ybabs/H745FCS/Hardware/CM4 Version/CM4.kicad_pcb

## KiCad design Hardware/CM4 Version/CM4.kicad_pcb (2022-01-23)

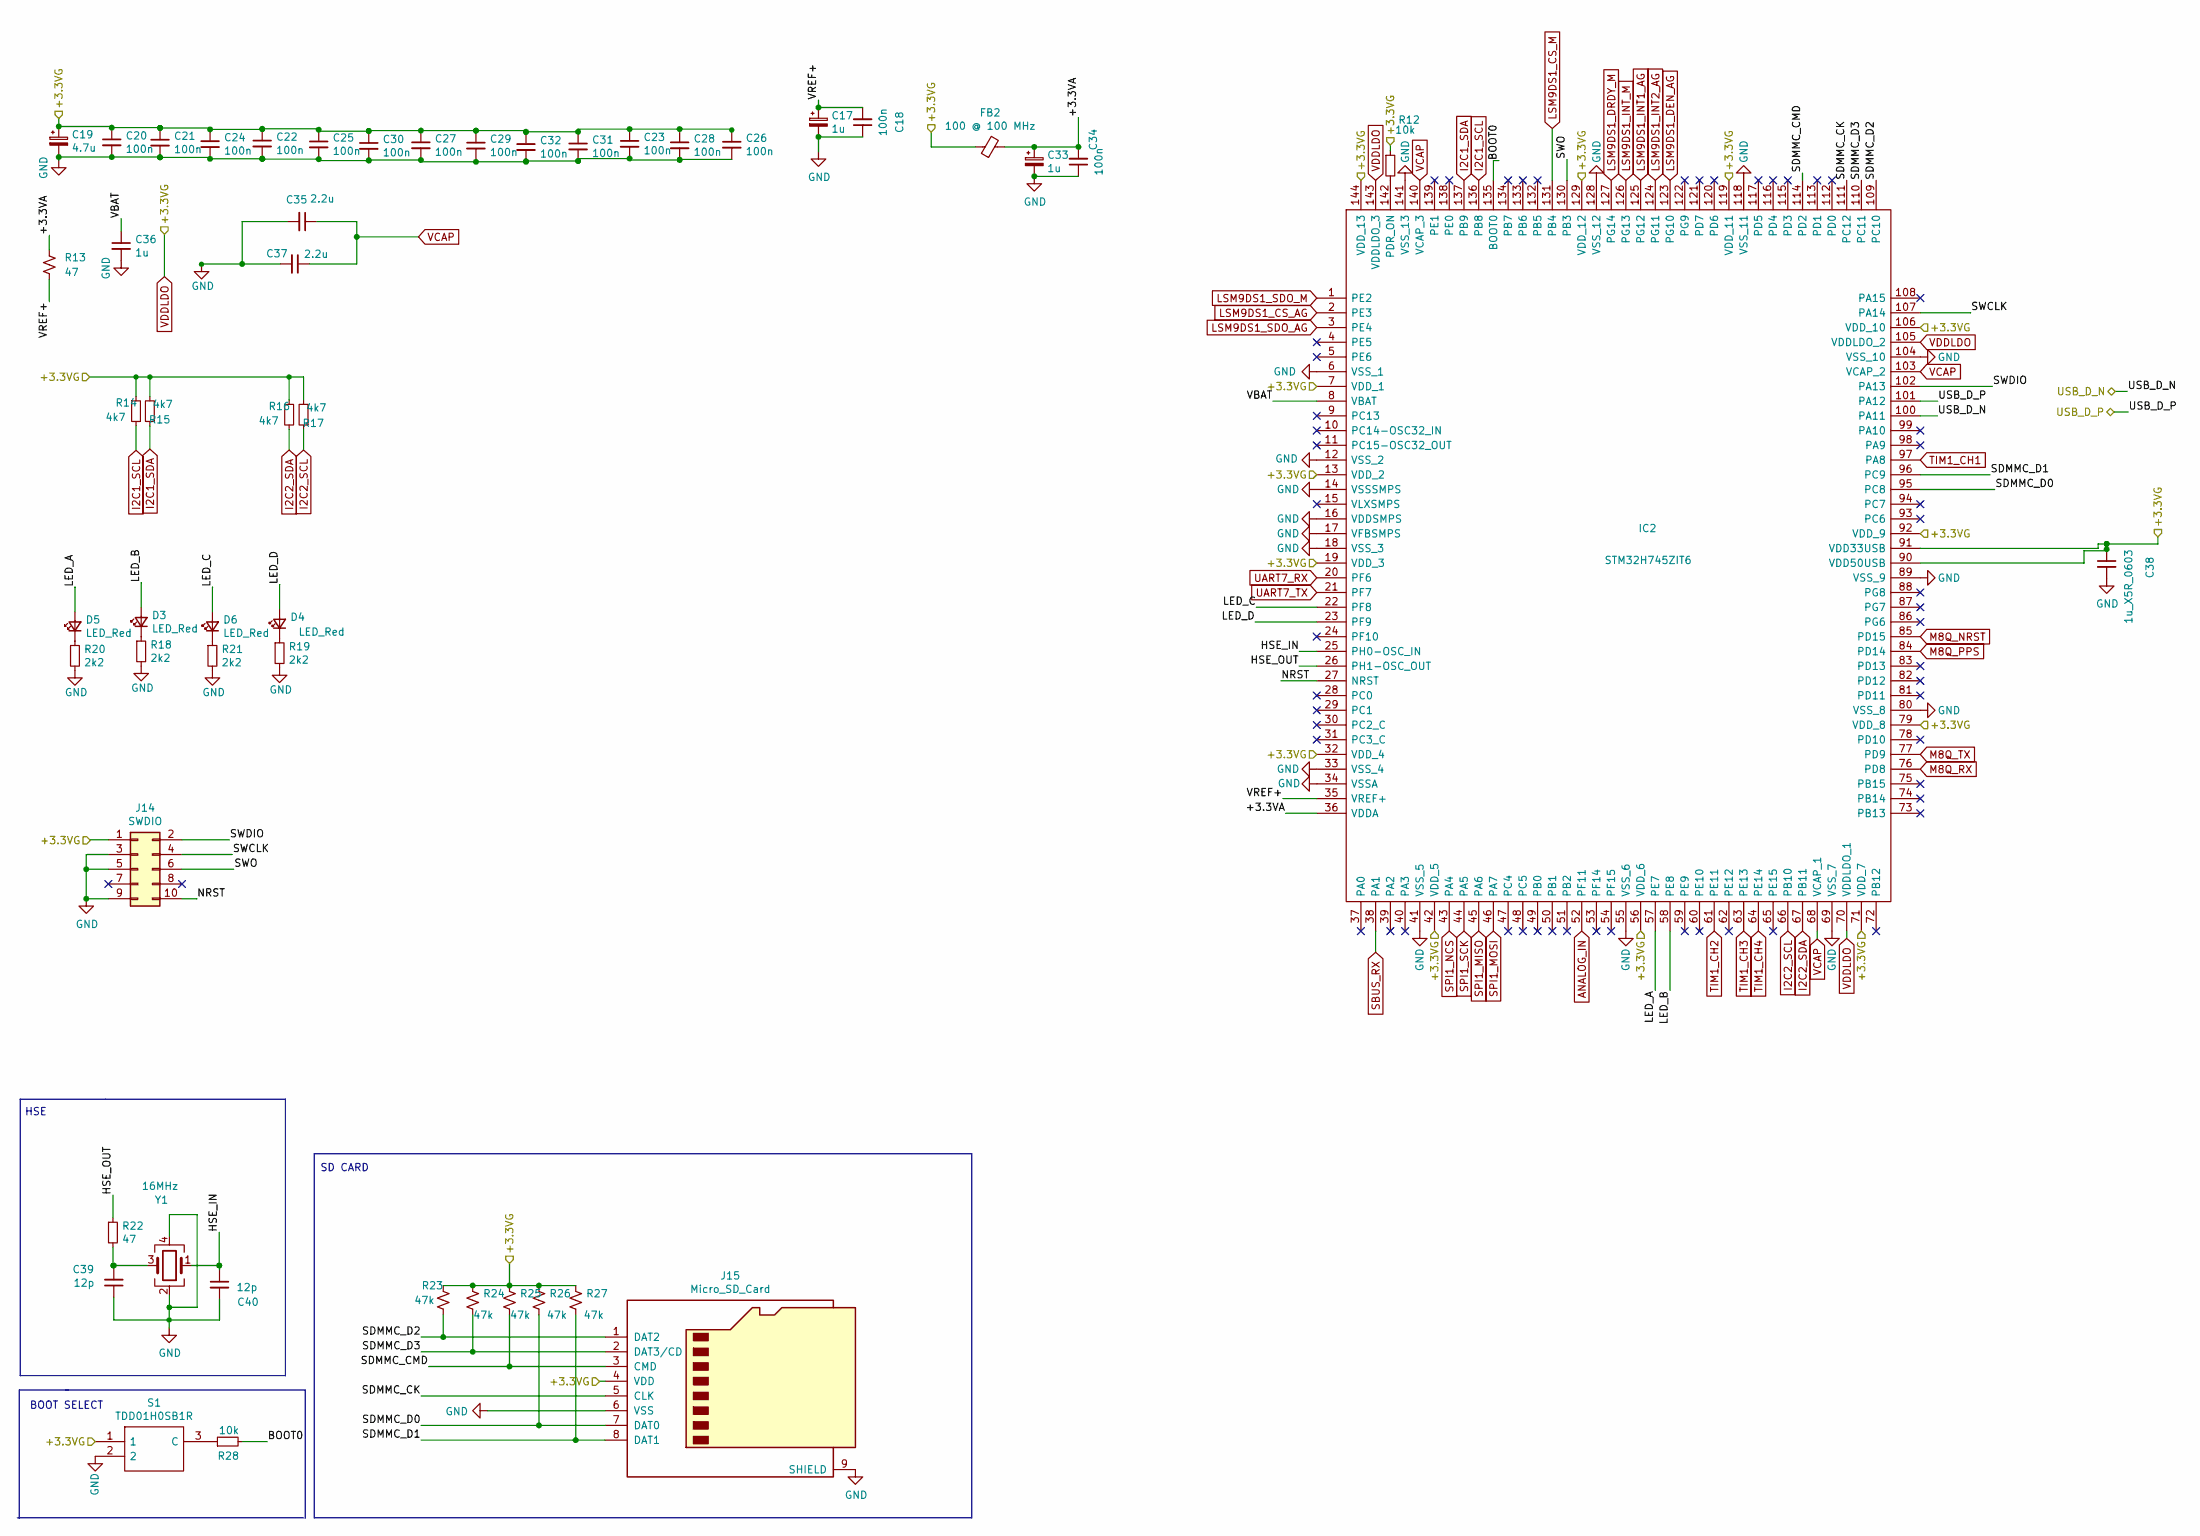
[picture p1: schematic H7MCU.kicad_sch]

Parts:
C17, C33: 1u; CP_EIA-3216-18_Kemet-A; Manufacturer_Part_Number TAJA105M016RNJ; LCSC Part # C7176
C18, C20, C21, C22, C23, C24, C25, C26, C27, C28, C29, C30, C31, C32, C34: 100n; C_0402_1005Metric; Digi-Key_PN 587-1226-2-ND
C19: 4.7u; CP_EIA-3216-18_Kemet-A; LCSC Part # C129235
C35, C37: 2.2u; C_0603_1608Metric; LCSC Part # C19666
C36: 1u; C_0402_1005Metric; Digi-Key_PN 587-1226-2-ND
C38: 1u_X5R_0603; C_0603_1608Metric; LCSC Part # C15849
C39, C40: 12p; C_0402_1005Metric; LCSC Part # C1547
D3, D4, D5, D6: LED_Red; LED_0603_1608Metric; LCSC Part # C72043
FB2: 100 @ 100 MHz; L_0603_1608Metric; Manufacturer_Part_Number MPZ1608S101ATAH0
IC2: STM32H745ZIT6; QFP50P2200X2200X160-144N; Manufacturer_Part_Number STM32H745ZIT6; Mouser Part Number 511-STM32H745ZIT6
J14: SWDIO; PinHeader_2x05_P1.27mm_Vertical
J15: Micro_SD_Card; microSD_HC_Hirose_DM3AT-SF-PEJM5; Manufacturer_Part_Number DM3AT-SF-PEJM5
R12, R28: 10k; R_0402_1005Metric; Digi-Key_PN RG10P10.0KDTR-ND
R13, R22: 47; R_0402_1005Metric; LCSC Part # C23182
R14, R15, R16, R17: 4k7; R_0402_1005Metric; LCSC Part # C23162
R18, R19, R20, R21: 2k2; R_0603_1608Metric; LCSC Part # C4190
R23, R24, R25, R26, R27: 47k; R_0402_1005Metric; Digi-Key_PN P47KDCTR-ND
S1: TDD01H0SB1R; SOT175P420X230-3N; Manufacturer_Part_Number TDD01H0SB1R; Mouser Part Number 611-TDD01H0SB1R
Y1: 16MHz; Crystal_SMD_3225-4Pin_3.2x2.5mm; Manufacturer_Part_Number X322516MLB4SI; LCSC Part # C13738

Connections:
/MCU/+3.3VA: C33.1, C34.2, FB2.2, IC2.36 (VDDA), R13.2
/MCU/BOOT0: IC2.135 (BOOT0), R28.2
/MCU/HSE_IN: C40.1, IC2.25 (PH0-OSC_IN), Y1.1
/MCU/HSE_OUT: IC2.26 (PH1-OSC_OUT), R22.1
/MCU/LED_A: D5.2 (A), IC2.57 (PE7)
/MCU/LED_B: D3.2 (A), IC2.58 (PE8)
/MCU/LED_C: D6.2 (A), IC2.22 (PF8)
/MCU/LED_D: D4.2 (A), IC2.23 (PF9)
/MCU/NRST: IC2.27 (NRST), J14.10
/MCU/SDMMC_CK: IC2.111 (PC12), J15.5 (CLK)
/MCU/SDMMC_CMD: IC2.114 (PD2), J15.3 (CMD), R25.1
/MCU/SDMMC_D0: IC2.95 (PC8), J15.7 (DAT0), R26.1
/MCU/SDMMC_D1: IC2.96 (PC9), J15.8 (DAT1), R27.1
/MCU/SDMMC_D2: IC2.109 (PC10), J15.1 (DAT2), R23.1
/MCU/SDMMC_D3: IC2.110 (PC11), J15.2 (DAT3/CD), R24.1
/MCU/SWCLK: IC2.107 (PA14), J14.4
/MCU/SWDIO: IC2.102 (PA13), J14.2
/MCU/SWO: IC2.130 (PB3), J14.6
/MCU/VBAT: C36.1, IC2.8 (VBAT)
/MCU/VREF+: C17.1, C18.2, IC2.35 (VREF+), R13.1
GND: C17.2, C18.1, C19.2, C20.2, C21.2, C22.2, C23.2, C24.2, C25.2, C26.2, C27.2, C28.2, C29.2, C30.2, C31.2, C32.2, C33.2, C34.1, C35.2, C36.2, C37.2, C38.2, C39.1, C40.2, IC2.6 (VSS_1), IC2.12 (VSS_2), IC2.14 (VSSSMPS), IC2.16 (VDDSMPS), IC2.17 (VFBSMPS), IC2.18 (VSS_3), IC2.33 (VSS_4), IC2.34 (VSSA), IC2.41 (VSS_5), IC2.55 (VSS_6), IC2.69 (VSS_7), IC2.80 (VSS_8), IC2.89 (VSS_9), IC2.104 (VSS_10), IC2.118 (VSS_11), IC2.128 (VSS_12), IC2.141 (VSS_13), J14.3, J14.5, J14.9, J15.6 (VSS), J15.9 (SHIELD), R18.2, R19.2, R20.2, R21.2, S1.2, Y1.2, Y1.4; also elsewhere on the board
I2C1_SCL: IC2.136 (PB8), R14.2; also elsewhere on the board
I2C1_SDA: IC2.137 (PB9), R15.1; also elsewhere on the board
I2C2_SCL: IC2.66 (PB10), R17.1; also elsewhere on the board
I2C2_SDA: IC2.67 (PB11), R16.2; also elsewhere on the board
unnamed: C39.2, R22.2, Y1.3
unnamed: D3.1 (K), R18.1
unnamed: D4.1 (K), R19.1
unnamed: D5.1 (K), R20.1
unnamed: D6.1 (K), R21.1
unnamed: IC2.142 (PDR_ON), R12.2
unnamed: R28.1, S1.3 (C)
VCAP: C35.1, C37.1, IC2.68 (VCAP_1), IC2.103 (VCAP_2), IC2.140 (VCAP_3)
VDDLDO: C19.1, C20.1, C21.1, C22.1, C23.1, C24.1, C25.1, C26.1, C27.1, C28.1, C29.1, C30.1, C31.1, C32.1, C38.1, FB2.1, IC2.7 (VDD_1), IC2.13 (VDD_2), IC2.19 (VDD_3), IC2.32 (VDD_4), IC2.42 (VDD_5), IC2.56 (VDD_6), IC2.70 (VDDLDO_1), IC2.71 (VDD_7), IC2.79 (VDD_8), IC2.90 (VDD50USB), IC2.91 (VDD33USB), IC2.92 (VDD_9), IC2.105 (VDDLDO_2), IC2.106 (VDD_10), IC2.119 (VDD_11), IC2.129 (VDD_12), IC2.143 (VDDLDO_3), IC2.144 (VDD_13), J14.1, J15.4 (VDD), R12.1, R14.1, R15.2, R16.1, R17.2, R23.2, R24.2, R25.2, R26.2, R27.2, S1.1; also elsewhere on the board

Notes on the sheet:
SD CARD
HSE
BOOT SELECT

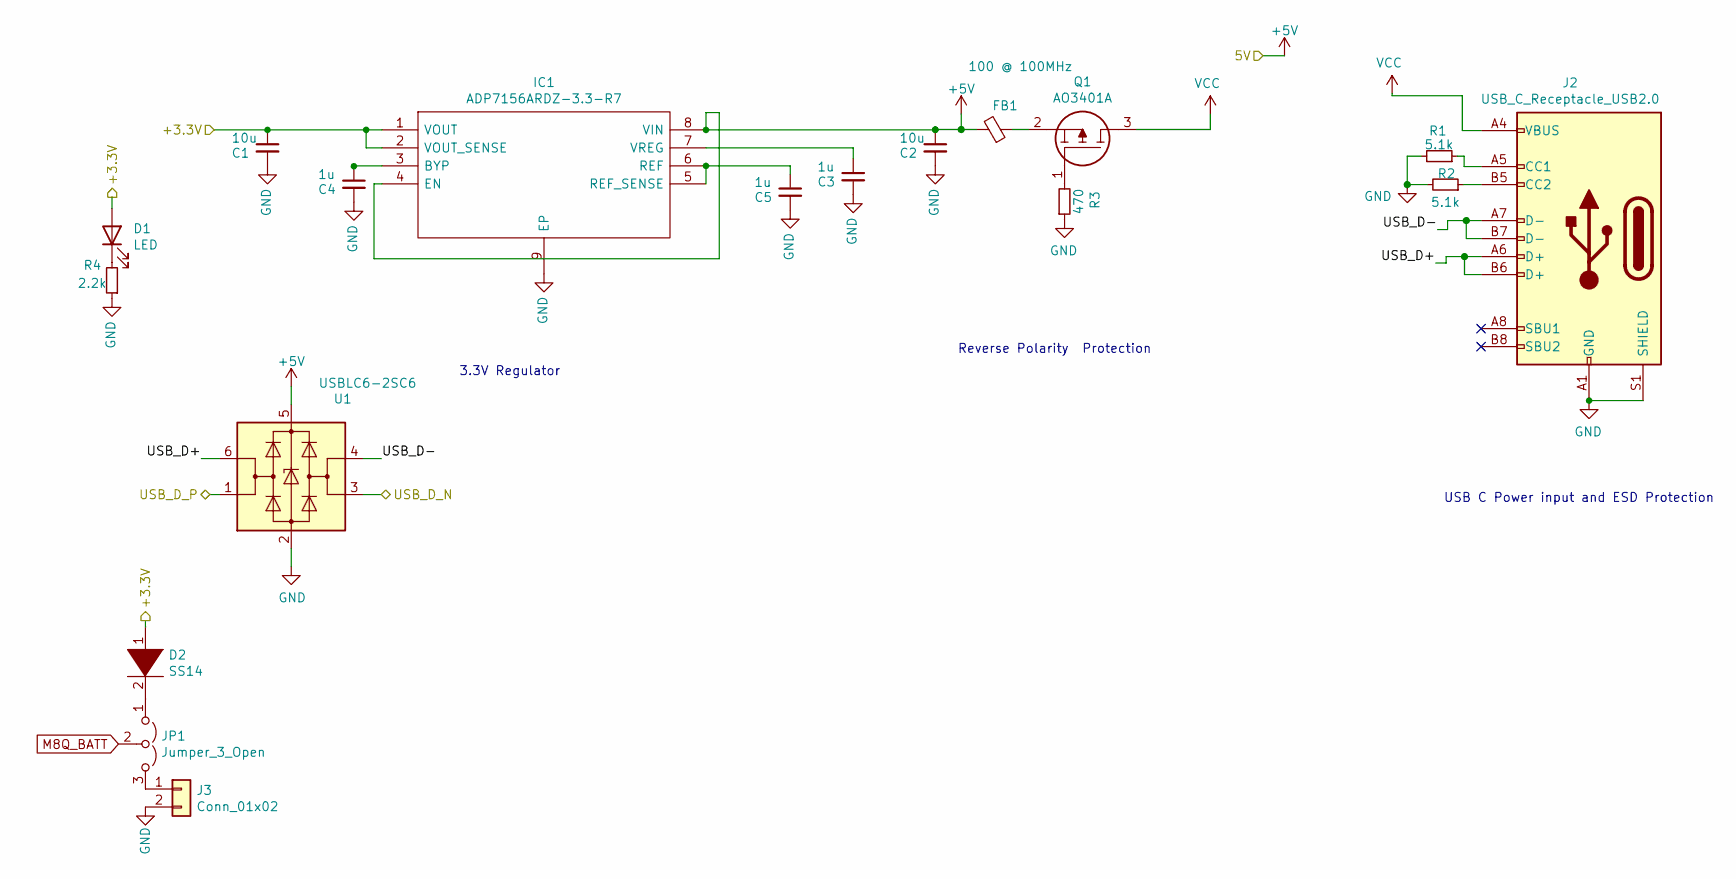
[picture p2: schematic power.kicad_sch]

Parts:
C1, C2: 10u; C_0603_1608Metric; LCSC Part # C19702
C3, C4, C5: 1u; C_0603_1608Metric; LCSC Part # C15849
D1: LED; LED_0603_1608Metric; LCSC Part # C72043
D2: SS14; D_SMA; LCSC Part # C111631
FB1: 100 @ 100MHz; L_0603_1608Metric; Manufacturer_Part_Number BLM21PG600SH1D
IC1: ADP7156ARDZ-3.3-R7; SOIC127P600X175-9N; Manufacturer_Part_Number ADP7156ARDZ-3.3-R7; Mouser Part Number 584-ADP7156ARDZ3.3R7
J2: USB_C_Receptacle_USB2.0; USB_C_Receptacle_HRO_TYPE-C-31-M-12; Manufacturer_Part_Number TYPE-C-31-M-12; LCSC Part # C165948
J3: Conn_01x02; Molex_PicoBlade_53261-0271_1x02-1MP_P1.25mm_Horizontal; Manufacturer_Part_Number 0532610271; Digi-Key_PN WM7620TR-ND
JP1: Jumper_3_Open; SolderJumper-3_P1.3mm_Open_RoundedPad1.0x1.5mm
Q1: AO3401A; SOT95P280X125-3N; Manufacturer_Part_Number AO3401A
R1, R2: 5.1k; R_1206_3216Metric; LCSC Part # C26033
R3: 470; R_1206_3216Metric; LCSC Part # C26033
R4: 2.2k; R_0603_1608Metric; LCSC Part # C4190
U1: USBLC6-2SC6; SOT-23-6; Manufacturer_Part_Number USBLC6-2SC6; LCSC Part # C7519

Connections:
+5V: C2.1, FB1.2, IC1.4 (EN), IC1.8 (VIN), U1.5 (VBUS); also elsewhere on the board
/Power/USB_D+: J2.A6 (D+), J2.B6 (D+), U1.6 (I/O1)
/Power/USB_D-: J2.A7 (D-), J2.B7 (D-), U1.4 (I/O2)
/Power/USB_D_N: U1.3 (I/O2)
/Power/USB_D_P: U1.1 (I/O1)
GND: C1.2, C2.2, C3.2, C4.2, C5.2, IC1.9 (EP), J2.A1 (GND), J2.A12 (GND), J2.B1 (GND), J2.B12 (GND), J2.S1 (SHIELD), J3.2, R1.2, R2.2, R3.1, R4.1, U1.2 (GND); also elsewhere on the board
M8Q_BATT: JP1.2 (C)
unnamed: C3.1, IC1.7 (VREG)
unnamed: C4.1, IC1.3 (BYP)
unnamed: C5.1, IC1.5 (REF_SENSE), IC1.6 (REF)
unnamed: D1.1 (K), R4.2
unnamed: D2.2 (A), JP1.1 (A)
unnamed: FB1.1, Q1.2
unnamed: J2.A5 (CC1), R1.1
unnamed: J2.B5 (CC2), R2.1
unnamed: J3.1, JP1.3 (B)
unnamed: Q1.1, R3.2
VCC: J2.A4 (VBUS), J2.A9 (VBUS), J2.B4 (VBUS), J2.B9 (VBUS), Q1.3
VDDLDO: C1.1, D1.2 (A), D2.1 (K), IC1.1 (VOUT), IC1.2 (VOUT_SENSE); also elsewhere on the board

Notes on the sheet:
3.3V Regulator
Reverse Polarity Protection
USB C Power input and ESD Protection

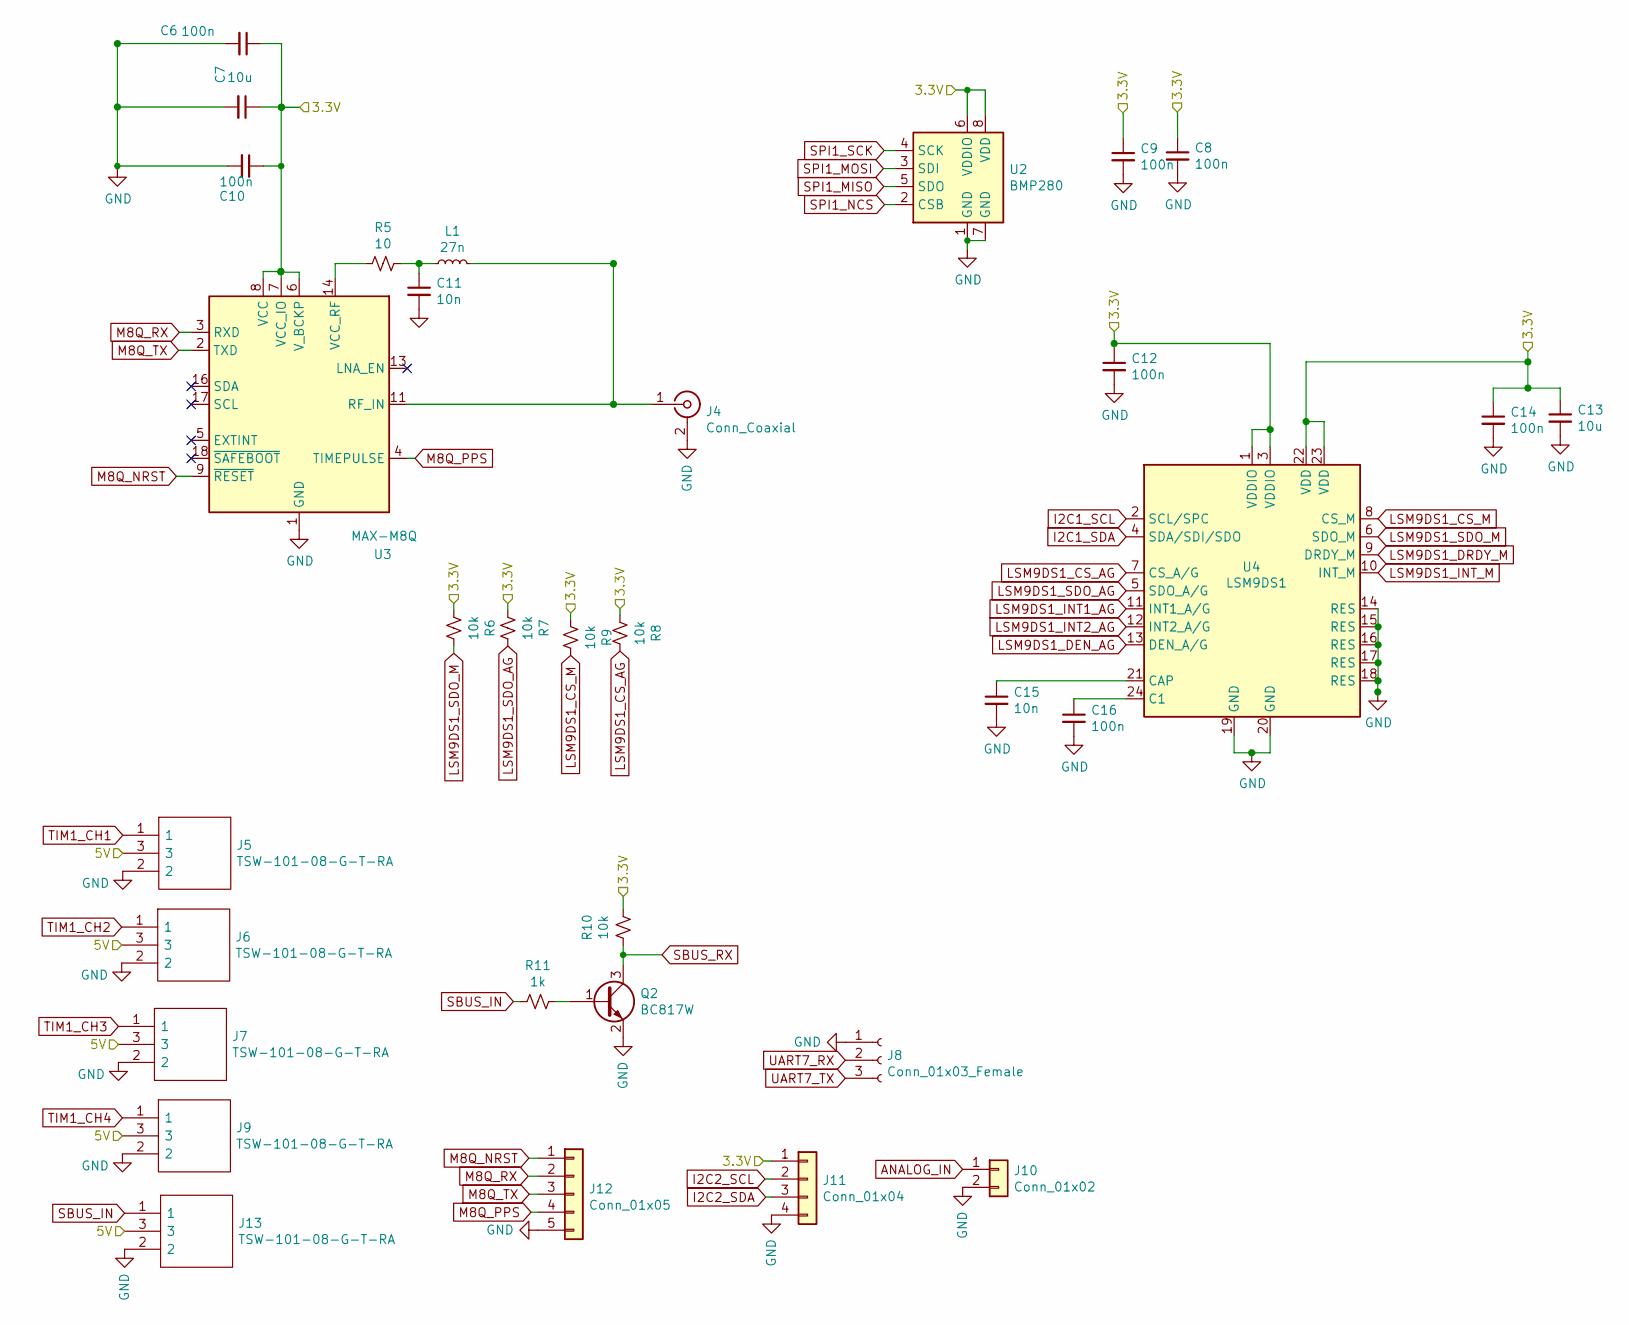
[picture p3: schematic Sensors.kicad_sch]

Parts:
C6, C8, C9, C10, C12, C14, C16: 100n; C_0402_1005Metric; Digi-Key_PN 587-1226-2-ND
C7: 10u; C_0603_1608Metric; LCSC Part # C15849
C11, C15: 10n; C_0402_1005Metric; LCSC Part # C15195
C13: 10u; C_0603_1608Metric; LCSC Part # C19702
J4: Conn_Coaxial; BWIPX-1-001E
J5, J6, J7, J9, J13: TSW-101-08-G-T-RA; HDRRA3W64P254_3X1_254X254X810P; Mouser Part Number 200-HTSW10108GTRA
J8: Conn_01x03_Female; PinHeader_1x03_P2.54mm_Vertical
J10: Conn_01x02; Molex_PicoBlade_53048-0210_1x02_P1.25mm_Horizontal; Manufacturer_Part_Number 0530480210; Digi-Key_PN WM1742-ND
J11: Conn_01x04; Molex_PicoBlade_53261-0471_1x04-1MP_P1.25mm_Horizontal; Manufacturer_Part_Number 0532610471; Digi-Key_PN WM7622TR-ND
J12: Conn_01x05; Molex_PicoBlade_53047-0510_1x05_P1.25mm_Vertical
L1: 27n; L_0402_1005Metric_Pad0.77x0.64mm_HandSolder; Manufacturer_Part_Number LQG15HS27NJ02D; LCSC Part # C18830
Q2: BC817W; SOT-323_SC-70; Digi-Key_PN 1727-4843-2-ND
R5: 10; R_0402_1005Metric; LCSC Part # C22859
R6, R7, R8, R9, R10: 10k; R_0402_1005Metric; Digi-Key_PN RG10P10.0KDTR-ND
R11: 1k; R_0402_1005Metric; LCSC Part # C21190
U2: BMP280; Bosch_LGA-8_2x2.5mm_P0.65mm_ClockwisePinNumbering; Manufacturer_Part_Number 314030010
U3: MAX-M8Q; ublox_MAX
U4: LSM9DS1; LGA-24L_3x3.5mm_P0.43mm; Digi-Key_PN 497-14946-2-ND

Connections:
ANALOG_IN: J10.1
GND: C6.2, C7.2, C8.2, C9.2, C10.2, C11.2, C12.2, C13.2, C14.2, C15.2, C16.2, J4.2 (Ext), J5.2, J6.2, J7.2, J8.1, J9.2, J10.2, J11.4, J12.5, J13.2, Q2.2 (E), U2.1 (GND), U2.7 (GND), U3.1 (GND), U3.10 (GND), U3.12 (GND), U4.14 (RES), U4.15 (RES), U4.16 (RES), U4.17 (RES), U4.18 (RES), U4.19 (GND), U4.20 (GND); also elsewhere on the board
I2C1_SCL: U4.2 (SCL/SPC); also elsewhere on the board
I2C1_SDA: U4.4 (SDA/SDI/SDO); also elsewhere on the board
I2C2_SCL: J11.2; also elsewhere on the board
I2C2_SDA: J11.3; also elsewhere on the board
LSM9DS1_CS_AG: R8.2, U4.7 (CS_A/G)
LSM9DS1_CS_M: R9.2, U4.8 (CS_M)
LSM9DS1_DEN_AG: U4.13 (DEN_A/G)
LSM9DS1_DRDY_M: U4.9 (DRDY_M)
LSM9DS1_INT1_AG: U4.11 (INT1_A/G)
LSM9DS1_INT2_AG: U4.12 (INT2_A/G)
LSM9DS1_INT_M: U4.10 (INT_M)
LSM9DS1_SDO_AG: R7.2, U4.5 (SDO_A/G)
LSM9DS1_SDO_M: R6.2, U4.6 (SDO_M)
M8Q_NRST: J12.1, U3.9 (~RESET)
M8Q_PPS: J12.4, U3.4 (TIMEPULSE)
M8Q_RX: J12.2, U3.3 (RXD)
M8Q_TX: J12.3, U3.2 (TXD)
unnamed: C11.1, L1.1, R5.2
unnamed: C15.1, U4.21 (CAP)
unnamed: C16.1, U4.24 (C1)
unnamed: J4.1 (In), L1.2, U3.11 (RF_IN)
unnamed: J5.3, J6.3, J7.3, J9.3, J13.3
unnamed: Q2.1 (B), R11.2
unnamed: R5.1, U3.14 (VCC_RF)
SBUS_IN: J13.1, R11.1
SBUS_RX: Q2.3 (C), R10.1
SPI1_MISO: U2.5 (SDO)
SPI1_MOSI: U2.3 (SDI)
SPI1_NCS: U2.2 (CSB)
SPI1_SCK: U2.4 (SCK)
UART7_RX: J8.2
UART7_TX: J8.3
VDDLDO: C6.1, C7.1, C8.1, C9.1, C10.1, C12.1, C13.1, C14.1, J11.1, R6.1, R7.1, R8.1, R9.1, R10.2, U2.6 (VDDIO), U2.8 (VDD), U3.6 (V_BCKP), U3.7 (VCC_IO), U3.8 (VCC), U4.1 (VDDIO), U4.3 (VDDIO), U4.22 (VDD), U4.23 (VDD); also elsewhere on the board

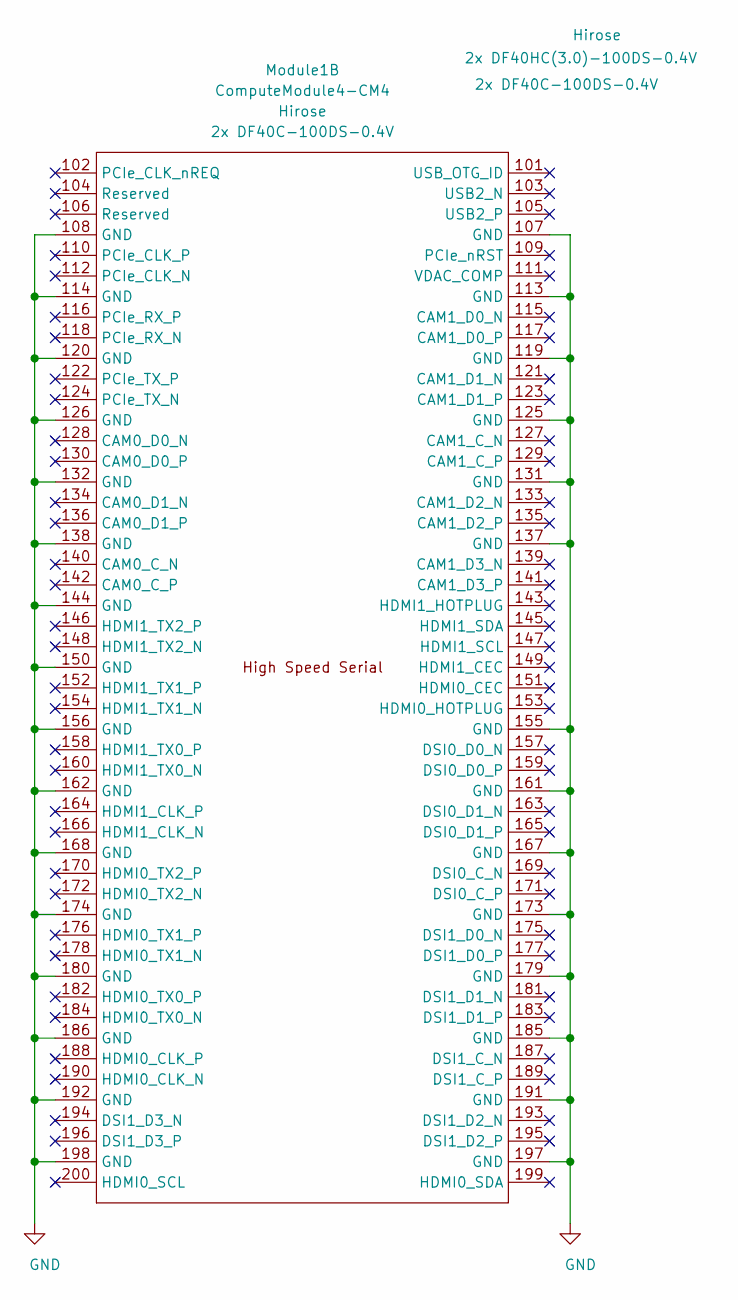
[picture p4: schematic cm4-high-speed.kicad_sch, Raspberry Pi Compute Module 4 Carrier Template]

Parts:
Module1: ComputeModule4-CM4; Raspberry-Pi-4-Compute-Module; MPN 2x DF40C-100DS-0.4V; Digi-Key_PN 2x H124602TR-ND

Connections:
GND: Module1.107 (GND), Module1.108 (GND), Module1.113 (GND), Module1.114 (GND), Module1.119 (GND), Module1.120 (GND), Module1.125 (GND), Module1.126 (GND), Module1.131 (GND), Module1.132 (GND), Module1.137 (GND), Module1.138 (GND), Module1.144 (GND), Module1.150 (GND), Module1.155 (GND), Module1.156 (GND), Module1.161 (GND), Module1.162 (GND), Module1.167 (GND), Module1.168 (GND), Module1.173 (GND), Module1.174 (GND), Module1.179 (GND), Module1.180 (GND), Module1.185 (GND), Module1.186 (GND), Module1.191 (GND), Module1.192 (GND), Module1.197 (GND), Module1.198 (GND); also elsewhere on the board

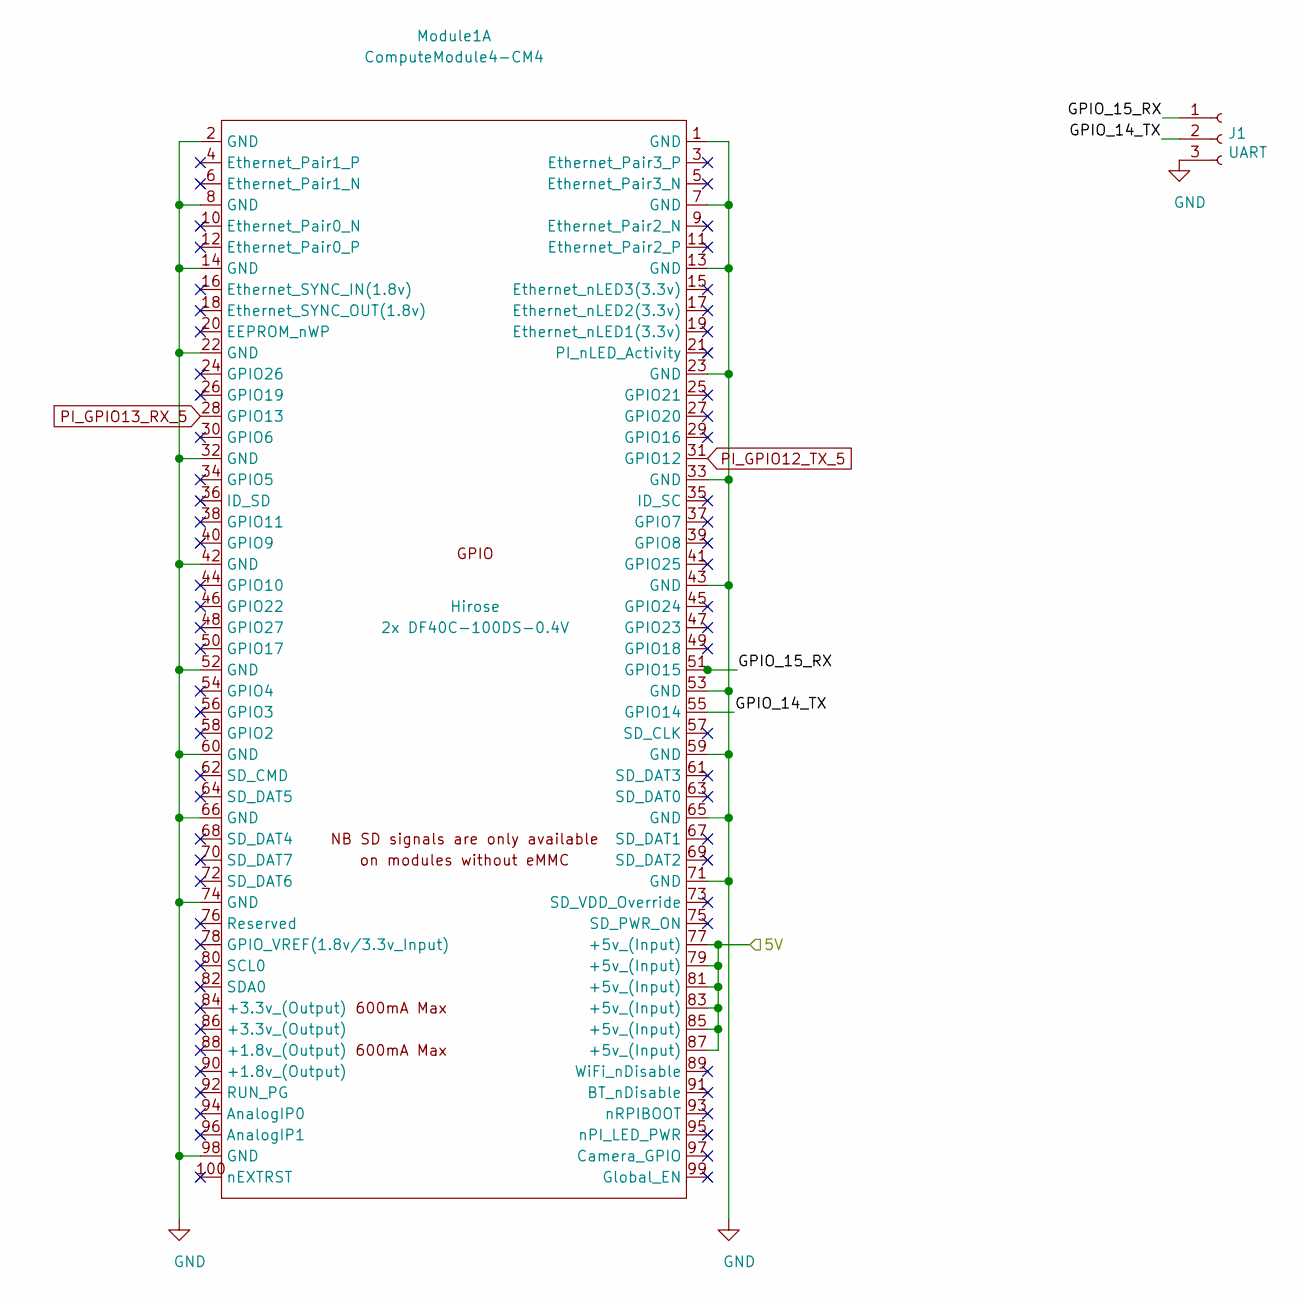
[picture p5: schematic cm4-gpio.kicad_sch, Raspberry Pi Compute Module 4 Carrier Template]

Parts:
J1: UART; Molex_PicoBlade_53261-0371_1x03-1MP_P1.25mm_Horizontal; Manufacturer_Part_Number 0532610371; Digi-Key_PN WM7621TR-ND
Module1: ComputeModule4-CM4; Raspberry-Pi-4-Compute-Module; MPN 2x DF40C-100DS-0.4V; Digi-Key_PN 2x H124602TR-ND

Connections:
+5V: Module1.77 (+5v_(Input)), Module1.79 (+5v_(Input)), Module1.81 (+5v_(Input)), Module1.83 (+5v_(Input)), Module1.85 (+5v_(Input)), Module1.87 (+5v_(Input)); also elsewhere on the board
/CM4 GPIO/GPIO_14_TX: J1.2, Module1.55 (GPIO14)
/CM4 GPIO/GPIO_15_RX: J1.1, Module1.51 (GPIO15)
GND: J1.3, Module1.1 (GND), Module1.2 (GND), Module1.7 (GND), Module1.8 (GND), Module1.13 (GND), Module1.14 (GND), Module1.22 (GND), Module1.23 (GND), Module1.32 (GND), Module1.33 (GND), Module1.42 (GND), Module1.43 (GND), Module1.52 (GND), Module1.53 (GND), Module1.59 (GND), Module1.60 (GND), Module1.65 (GND), Module1.66 (GND), Module1.71 (GND), Module1.74 (GND), Module1.98 (GND); also elsewhere on the board
PI_GPIO12_TX_5: Module1.31 (GPIO12)
PI_GPIO13_RX_5: Module1.28 (GPIO13)

Board: 4 copper layers, 94 parts (2 on the bottom side), 46 nets, no tracks yet.
