ybabs/H745FCS/Firmware/Baremetal/baremetal.ioc

Mcu.UserName=STM32H745ZITx
PA0.Signal=UART4_TX
PA1.Signal=UART4_RX
PA11.Signal=USB_OTG_FS_DM
PA12.Signal=USB_OTG_FS_DP
PA4.Signal=GPIO_Output
PA5.Signal=SPI1_SCK
PA6.Signal=SPI1_MISO
PA7.Signal=SPI1_MOSI
PA8.Signal=S_TIM1_CH1
PB10.Signal=I2C2_SCL
PB11.Signal=I2C2_SDA
PB8.Signal=I2C1_SCL
PB9.Signal=I2C1_SDA
PC10.Signal=SDMMC1_D2
PC11.Signal=SDMMC1_D3
PC12.Signal=SDMMC1_CK
PC8.Signal=SDMMC1_D0
PC9.Signal=SDMMC1_D1
PD14.Signal=GPIO_Output
PD15.Signal=GPIO_Output
PD2.Signal=SDMMC1_CMD
PD8.Signal=USART3_TX
PD9.Signal=USART3_RX
PE11.Signal=S_TIM1_CH2
PE13.Signal=S_TIM1_CH3
PE14.Signal=S_TIM1_CH4
PE7.GPIO_Label=LED_A
PE7.Signal=GPIO_Output
PE8.GPIO_Label=LED_B
PE8.Signal=GPIO_Output
PF11.Signal=ADC1_INP2
PF6.Signal=UART7_RX
PF7.Signal=UART7_TX
PF8.GPIO_Label=LED_C
PF8.Signal=GPIO_Output
PF9.GPIO_Label=LED_D
PF9.Signal=GPIO_Output
