ybabs/H745FCS/(commit log)

2020-08-02 Added Motor Driver
2020-08-12 Added Accelerometer driver
2020-08-19 Added Gyro driver
2020-09-29 Added GPS Driver
2021-04-05 Merged Hardware files with firmware
    [CM4-BOM-V2.csv, CM4-BOM_JLC.csv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]
2021-07-06 Set initial cUbeMX Cconfig. Fixed Clock and GPIO bug
    [CM4-B_Cu.gbr, CM4-B_Mask.gbr, CM4-B_Paste.gbr, CM4-B_Silkscreen.gbr, CM4-Edge_Cuts.gbr, CM4-F_Cu.gbr, CM4-F_Mask.gbr, CM4-F_Paste.gbr]
2021-07-07 Added GPS driver. Need to figure out why pressure sensor doesn't work
    [bmp280.c, bmp280.h, gpio.c, main.c]
2021-08-16 Added GPS Driver for Baremetal
2021-08-19 Fixed Dualcore Debug issue and changed IMU to bloc king function
    [bmp280.c, bmp280.h, lsm9ds1.c, lsm9ds1.h, main.c]
2021-11-16 Added RC Filter
2021-12-30 Refactor IMU CODE
2022-01-02 Refactor GPS Driver
2022-01-04 Changed BMP280 Driver to blocking
2022-01-04 Finished M4 Drivers
2022-01-23 update gitignore
    [CM4.kicad_pcb, CM4.kicad_sch, H7MCU.kicad_sch, Sensors.kicad_sch, power.kicad_sch]
2022-01-23 Renove Filters folder
2022-01-23 Remove CM4-Backups
    [CM4.kicad_pcb, CM4.kicad_sch, H7MCU.kicad_sch, Sensors.kicad_sch, cm4-gpio.kicad_sch, cm4-high-speed.kicad_sch, power.kicad_sch]
2022-02-16 Add Madgwick and Mahony Filter
2022-03-08 Change SBUS UART to use IDLE line detection
2022-03-13 Add LED heartbeat
2022-04-09 Fix errors with update to Cube 1.9.0 fcommon issue
    [bmp280.c, bmp280.h, lsm9ds1.c, lsm9ds1.h, main.c, sbus.c, sbus.h, ublox.c]
2022-04-09 Add LPF Imu data
2022-04-16 Add LP filter to IMU
2022-04-21 Add VCP Uart Interface
2022-04-22 Send Sensor data over USB using new structure
2022-05-26 Add UART Frame Parser
