ybabs/H745FCS/(notices)

Notices in the files:
Firmware/Baremetal/CM7/Core/Src/main.c:
This software component is licensed by ST under BSD 3-Clause license,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
Hardware/CM4 Version/cm4-gpio.kicad_sch:
creativecommons.org/licenses/by-sa/4.0
License: CC BY 4.0
Hardware/H7FC/CM4/CM4.kicad_pcb:
creativecommons.org/licenses/by/4.0
